richardbodonyi/f411-l817-tester/Images/build_settings.png

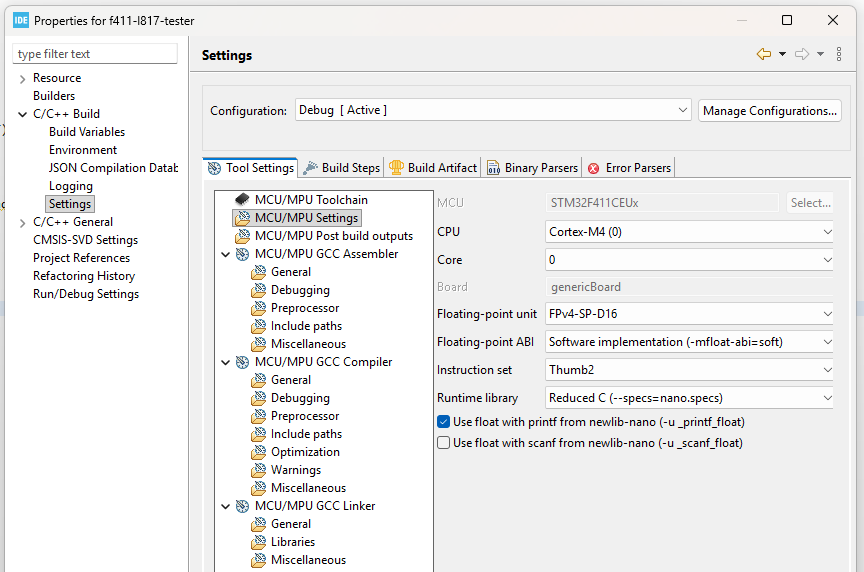
Images/build_settings.png
