richardbodonyi/f411-l817-tester/Core/Src/main.c

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
/* Includes ------------------------------------------------------------------*/
#include "main.h"
#include "adc.h"
#include "dma.h"
#include "i2c.h"
#include "tim.h"
#include "gpio.h"

/* USER CODE BEGIN Includes */

#include "ssd1306.h"
#include "measurements.h"

/* USER CODE END Includes */

/* USER CODE BEGIN PTD */

enum Mode {
	OPTOCOUPLER,
	REGULATOR
};

/* USER CODE END PTD */


/* USER CODE BEGIN PV */

volatile uint16_t adcValues[ADC_VALUE_COUNT];

volatile enum Mode mode = OPTOCOUPLER;

/* USER CODE END PV */

void SystemClock_Config(void);
/**
  * @brief  The application entry point.
  * @retval int
  */
int main(void)
{

  /* MCU Configuration--------------------------------------------------------*/

  /* Reset of all peripherals, Initializes the Flash interface and the Systick. */
  HAL_Init();

  /* Configure the system clock */
  SystemClock_Config();

  /* Initialize all configured peripherals */
  MX_GPIO_Init();
  MX_DMA_Init();
  MX_ADC1_Init();
  MX_I2C1_Init();
  MX_TIM2_Init();
  /* Infinite loop */
  /* USER CODE BEGIN WHILE */
  HAL_TIM_Base_Start(&htim2);
  HAL_ADC_Start_DMA(&hadc1, (uint32_t*) adcValues, ADC_VALUE_COUNT);
  ssd1306_Init();
  while (1)
  {
	  if (mode == OPTOCOUPLER) {
		  measureOptocoupler(OP_ON_GPIO_Port, OP_ON_Pin, &hadc1, adcValues);
	  	  HAL_Delay(100);
	  }
	  else {
		  measureRegulator(&hadc1, adcValues);
		  HAL_Delay(500);
	  }

    /* USER CODE END WHILE */

    /* USER CODE BEGIN 3 */
  }
  /* USER CODE END 3 */
}

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
/* USER CODE BEGIN 4 */

void HAL_GPIO_EXTI_Callback(uint16_t GPIO_Pin) {
    if (GPIO_Pin == GPIO_PIN_0) {
        static uint32_t lastInterruptTime = 0;
        uint32_t currentTime = HAL_GetTick();

        // 150ms software debounce lock
        if (currentTime - lastInterruptTime > 150) {
            if (mode == OPTOCOUPLER) {
            	mode = REGULATOR;
            }
            else {
            	mode = OPTOCOUPLER;
            }
            lastInterruptTime = currentTime;
        }
    }
}

/* USER CODE END 4 */
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
