richardbodonyi/f411-l817-tester/Core/Inc/main.h

#define Key_Pin GPIO_PIN_0
#define Key_GPIO_Port GPIOA
#define Key_EXTI_IRQn EXTI0_IRQn
#define OP_ON_Pin GPIO_PIN_6
#define OP_ON_GPIO_Port GPIOA
#define PWM_Pin GPIO_PIN_8
#define PWM_GPIO_Port GPIOB
