richardbodonyi/f411-l817-tester/(commit log)

2026-08-31 pin configuration extended
2026-09-06 ADC, measurements and display
2026-09-08 trying to start PWM
2026-09-09 pwm made with hal functionality
2026-09-16 added optocoupler dark Vce and shunt regulator measurement
2026-09-17 readme and schematic
2026-09-17 schematic fix - ssd 1306 connection
2026-09-17 schematic fix - crosshair removed
2026-09-17 Update README with schematic and Getting Started
    Added a schematic image and updated the Getting Started section.
2026-09-17 schematic fix - TL431 supply voltage
2026-09-17 Remove schematic link from README
    Removed link to schematic image in README.
2026-09-23 TL431 measurement fixed, button driven selection, ADC DMA fixed
    [f411-l817-tester.ioc, main.c, main.h, measurements.c, measurements.h]
2026-09-23 fixing measurement anomalies, readme updated, images
    [f411-l817-tester.ioc, main.c, main.h, measurements.c]
